Nurasylpro/laser/README.md

# WeedZap: Laser Weeding Robot

A robot that finds weeds with a camera and a custom YOLO model, then drives a laser over each one to burn it. No chemicals, no pulling.

▶️ **Final versions in action:** [YouTube](https://youtu.be/jQHW0xfkkLQ?si=JcptZxX9xMJJeqWb) · [Instagram @w_eedzap](https://www.instagram.com/w_eedzap?stkn=MWl5ODRhbG5hM2NrYg%3D%3D&utm_source=qr)

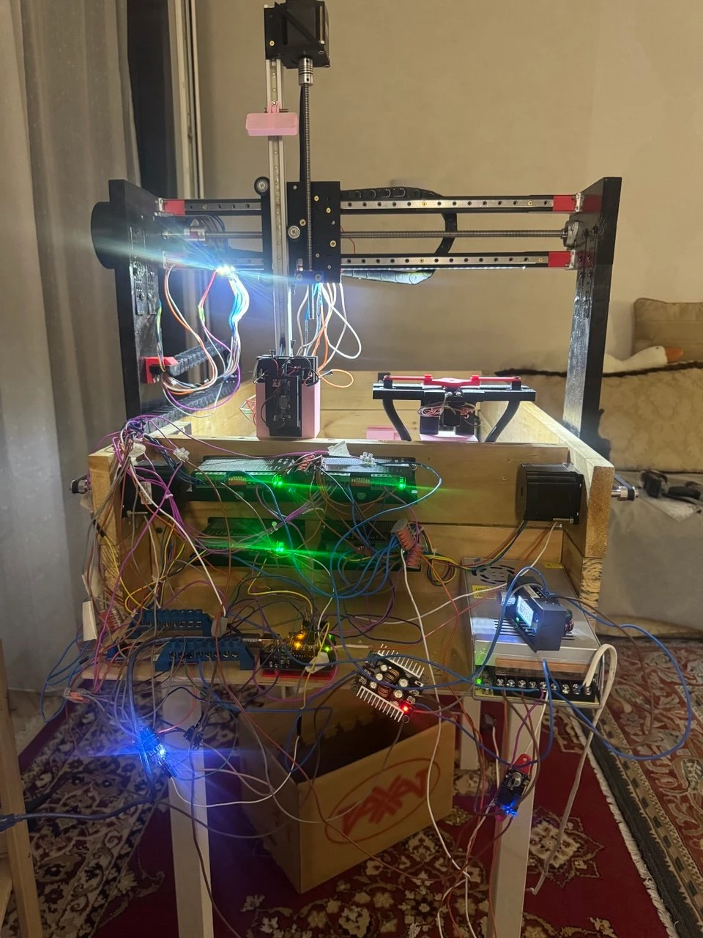
[picture p1: docs/story/gantry-current.webp]
The current WeedZap gantry with its camera, laser tool and drivers


## The story

### 1. It started with a laser in our hands

Before any robot, we had a simple question: can light kill a weed? We took a laser, went out to the garden, and pointed it at a weed by hand.

| Treating the weed by hand | The same weed the next day |
|---|---|
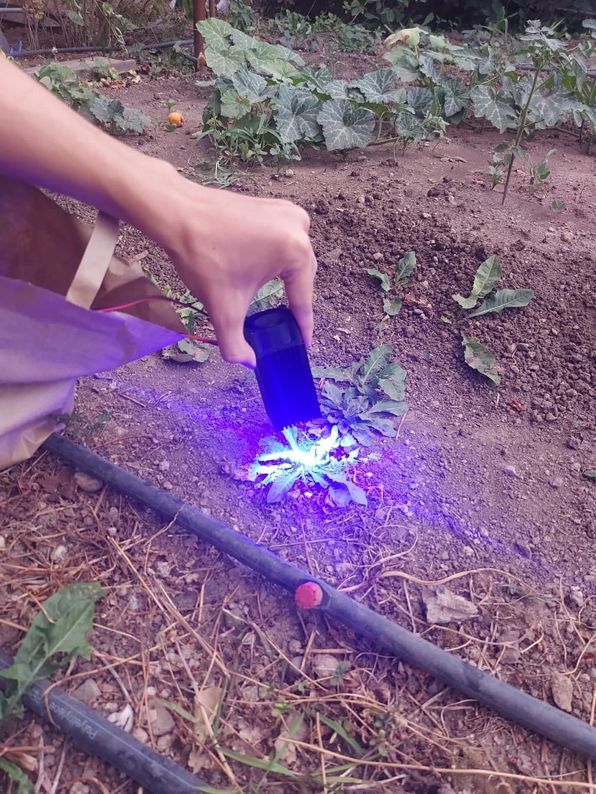
[picture p2: docs/story/hand-laser-test.webp]
Pointing a hand-held laser at a weed in the garden
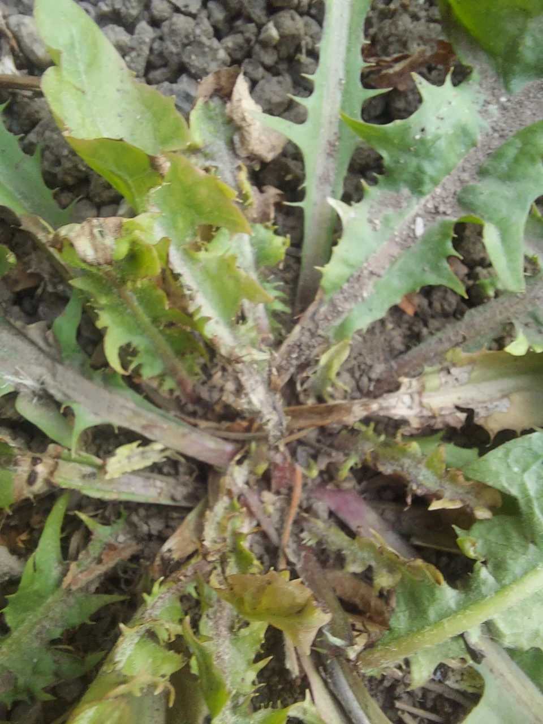
[picture p3: docs/story/weed-next-day.webp]
The treated weed the next day, with damaged stems
|  |  |

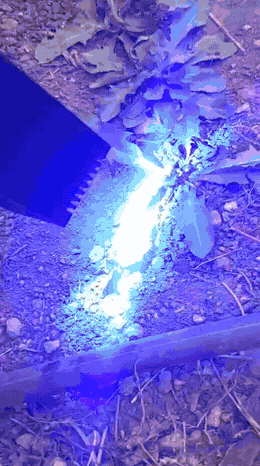
[picture p4: docs/story/first-hand-laser-test.gif]
Video of the first hand-held laser test


🎥 [Watch the full video with sound](docs/story/first-hand-laser-test.mp4)

The next day, the weed showed the answer. The laser had destroyed its **phloem and xylem**, the channels that carry water and nutrients between the root and the leaves. Without them, the plant can't feed its upper part, so it dies. We don't need to burn the whole weed. One precise shot in the right place is enough. That became the core idea of WeedZap.

### 2. Version 1: a small robot for the field

Our first robot was a small wheeled rover built with my team. It drove along the field with a camera. A carriage on a rail moved the laser sideways: the camera detected a weed, and the carriage moved the laser to that position.

| The first field robot | Testing it together |
|---|---|
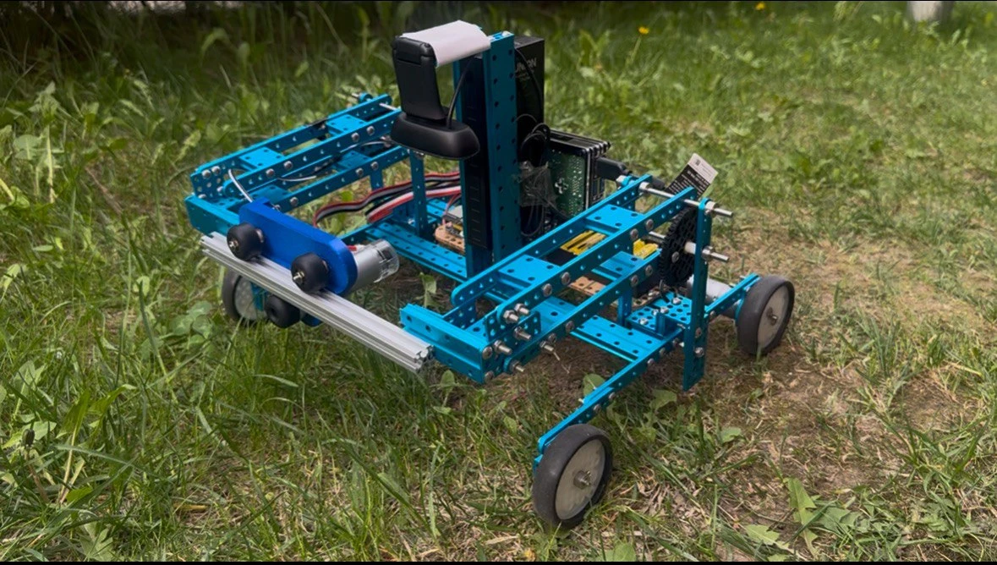
[picture p5: docs/story/v1-field-robot.webp]
The first WeedZap rover with camera and laser carriage on grass
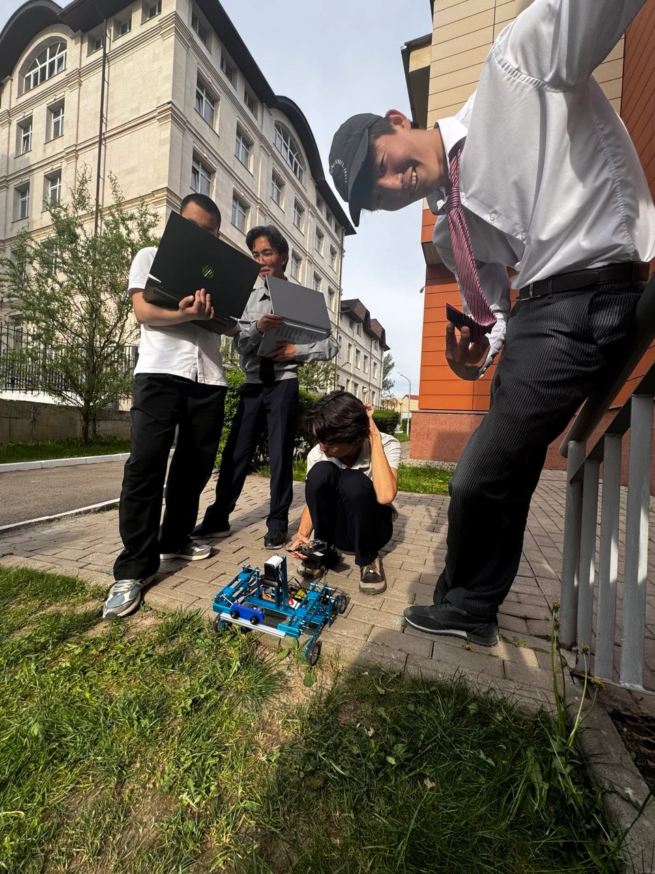
[picture p6: docs/story/v1-team-testing.webp]
The team testing the rover outside
|  |  |

We worked on it for weeks: wiring, coding and testing outside until it worked. Then we presented WeedZap at an exhibition, with a solar-powered frame and a robotic arm version.

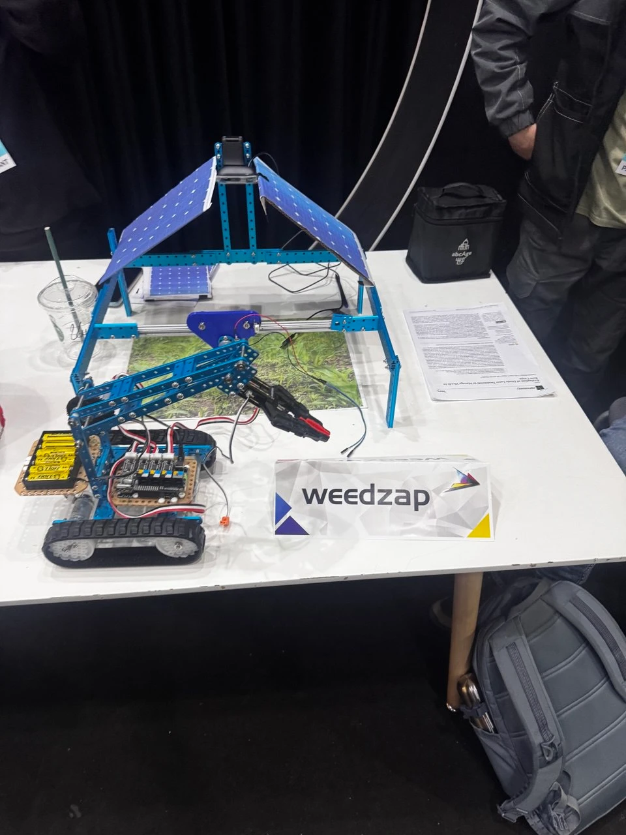
[picture p7: docs/story/v1-expo.webp]
WeedZap presented at the exhibition


### 3. A real high-power laser: NUBM44 V2

The hand test showed the idea works, but a field robot needs real power. We moved to the **NUBM44 V2** high-power blue laser diode. We worked with its driver, connected it to a microcontroller and built a small web page to control its power over Wi-Fi.

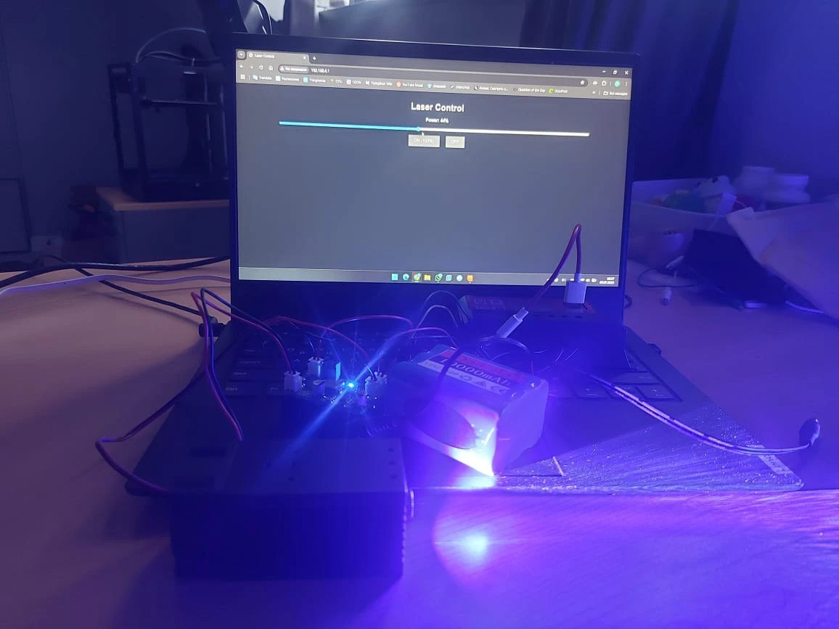
[picture p8: docs/story/nubm44-laser-control.webp]
Controlling the NUBM44 V2 laser power from a web page


### 4. The universal tool mount

For our smart greenhouse, we wanted the laser to work together with a mechanical tool. That meant designing a **universal tool mount**: one carriage that can pick up either the laser or a mechanical tool. This took a lot of design and many prints, more time than almost any other part.

| Design in CAD | Printed parts |
|---|---|
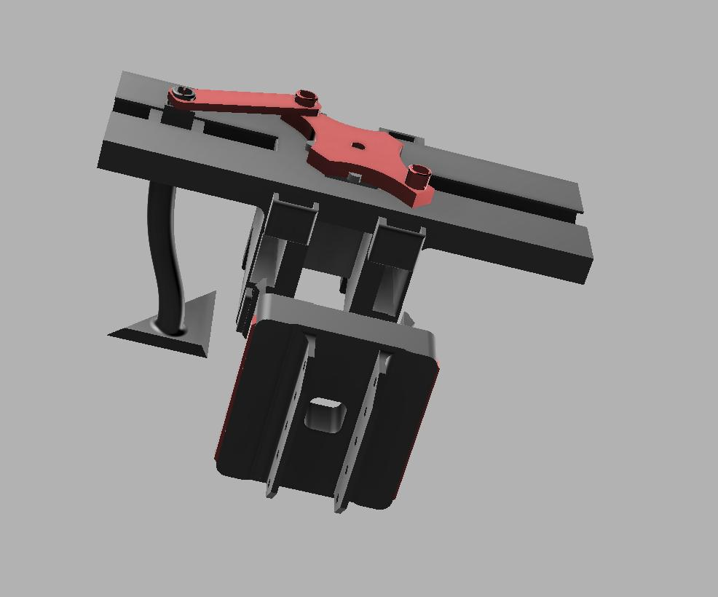
[picture p9: docs/story/tool-mount-cad.png]
CAD model of the universal tool mount
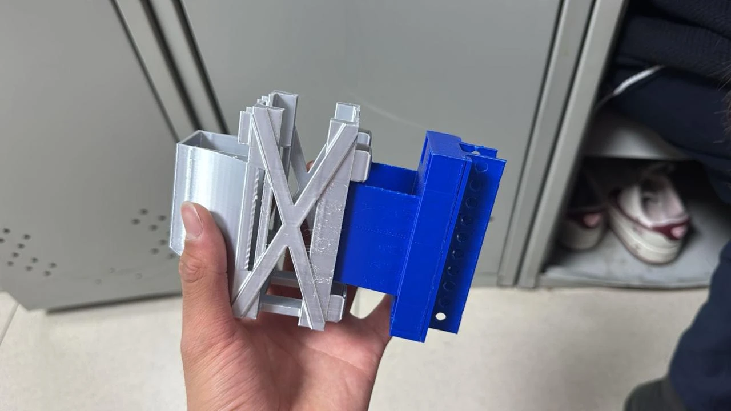
[picture p10: docs/story/tool-mount-printed.webp]
The 3D-printed tool mount parts
|  |  |

### 5. Teaching the robot to see weeds

A laser is useless if it doesn't know where to shoot, so we put a lot of work into computer vision. I collected many weeds myself, planted them in boxes, measured them and photographed them again and again. From those photos I built our own dataset, labelled it and trained **YOLO** models to find each weed and the exact point to hit.

| Growing and measuring weeds for the dataset | |
|---|---|
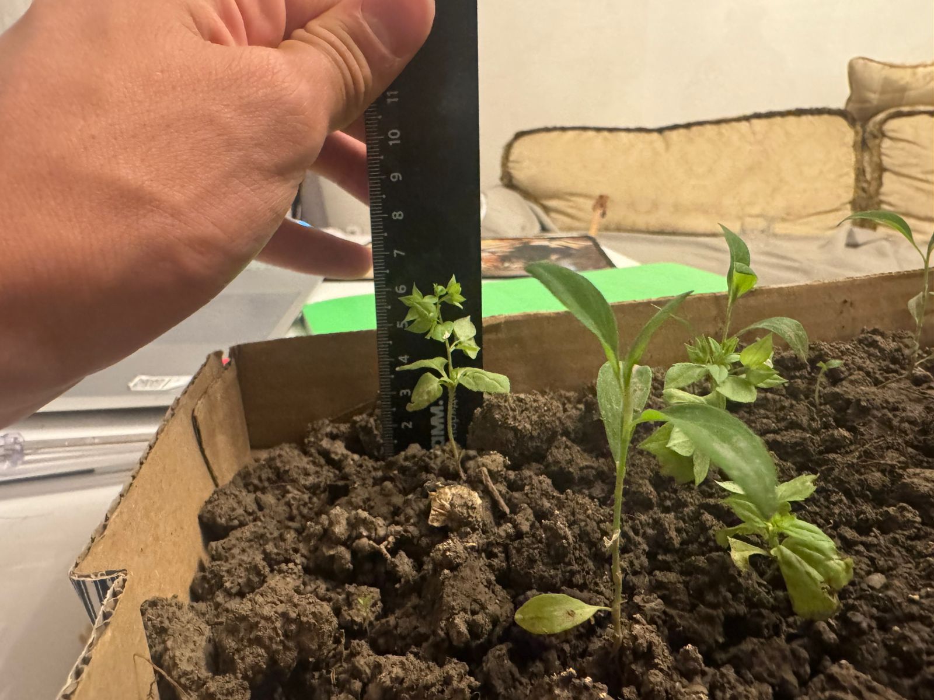
[picture p11: docs/story/weeds-measured-1.jpg]
Weeds planted in a box, measured with a ruler
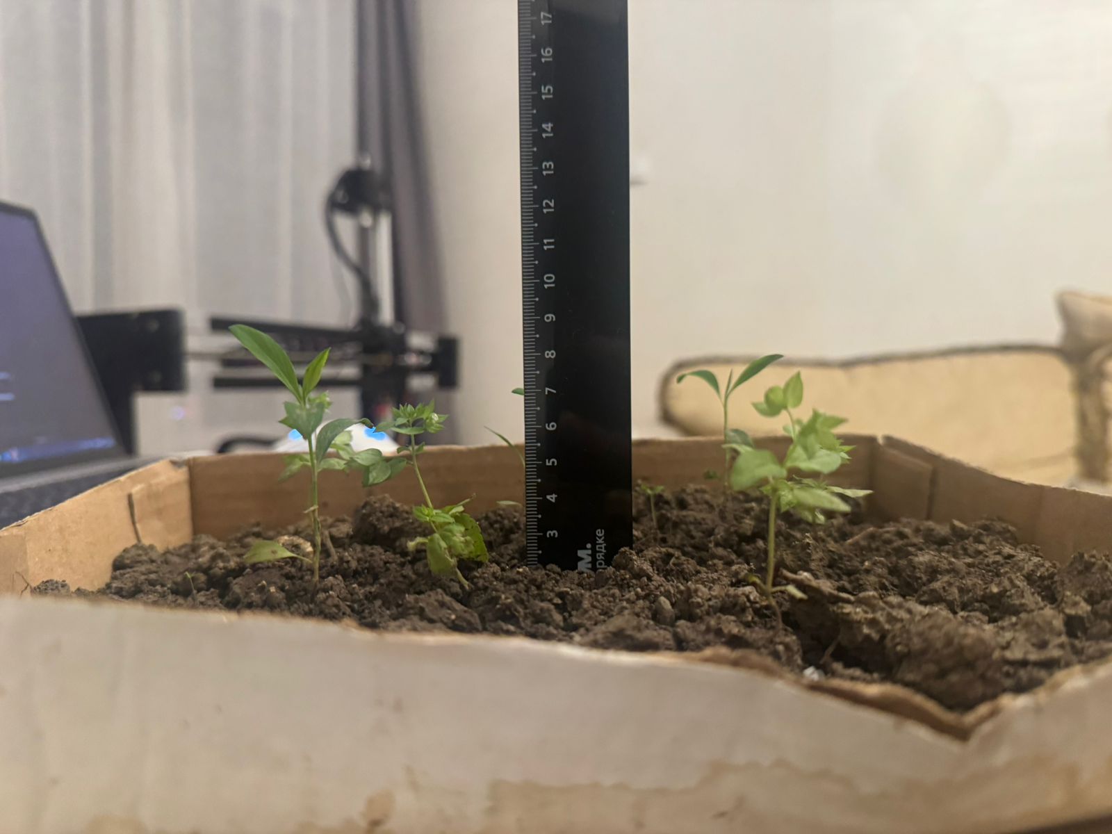
[picture p12: docs/story/weeds-measured-2.jpg]
Another set of weeds measured for the dataset
|  |  |

| What the trained model sees | Detection from the gantry camera |
|---|---|
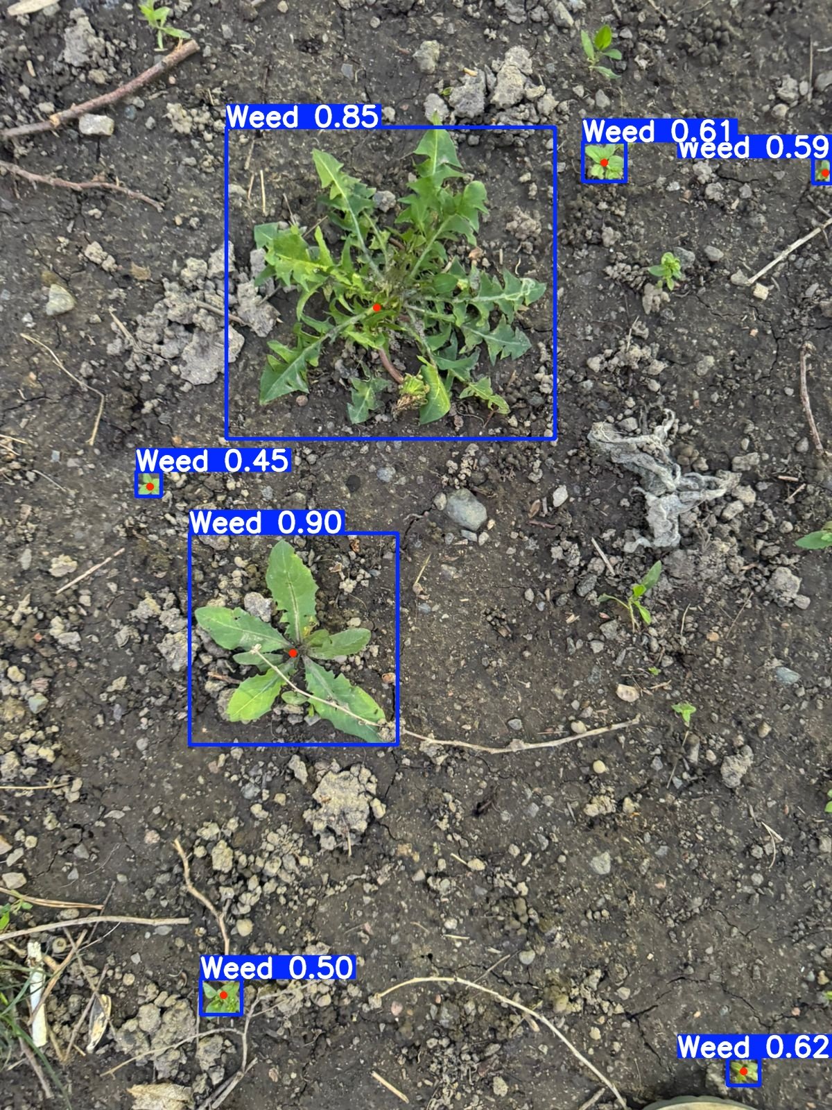
[picture p13: docs/images/weed-pose-model.jpg]
Weed pose model detections with confidence scores
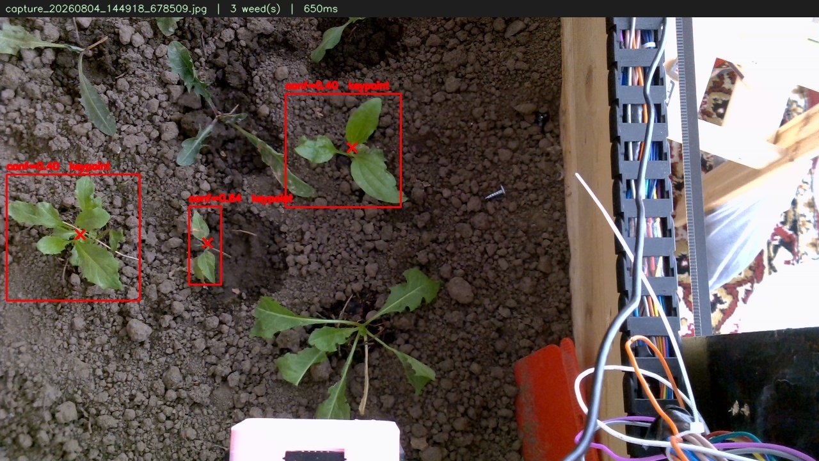
[picture p14: docs/images/gantry-detection.jpg]
Detected weeds from the gantry camera
|  |  |

### 6. Path planning between weeds

Once every weed is found, the robot plans the shortest route between them, so the laser visits each weed once without wasting time.

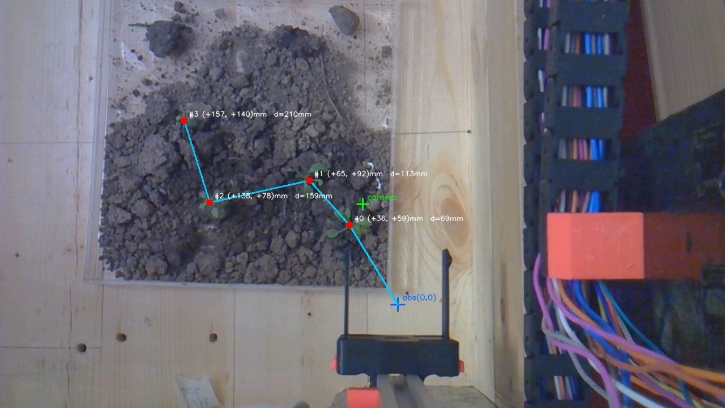
[picture p15: docs/images/path-planning.jpg]
Planned path between detected weeds


### 7. Today: the gantry

Everything came together in the current system: a gantry over the growing bed, a camera, the YOLO model, the NUBM44 laser and the tool mount. The rest of this README describes how it works.

| Zapping a weed in the soil bed | Testing late at night |
|---|---|
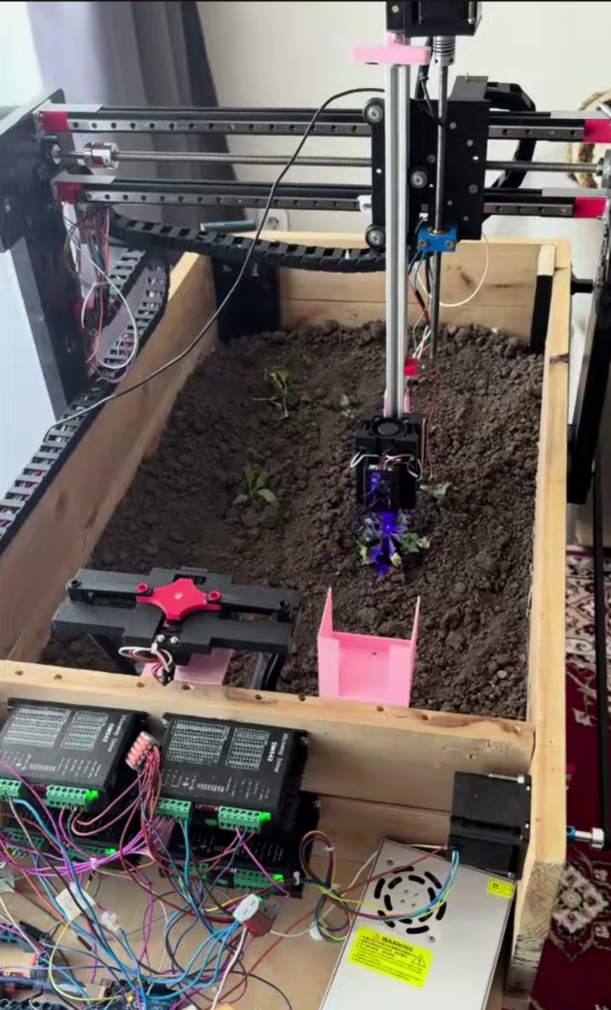
[picture p16: docs/story/gantry-zapping-weed.webp]
The gantry firing the laser at a weed in the soil bed
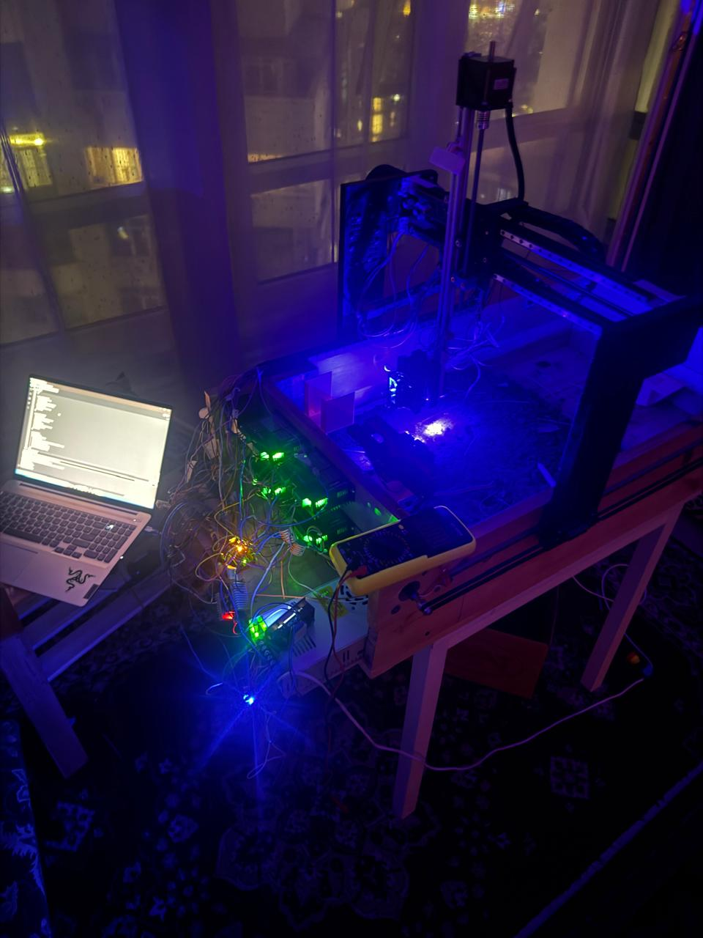
[picture p17: docs/story/gantry-night-test.jpg]
The gantry running a laser test at night
|  |  |

👉 For the final version of each part, watch the videos on [YouTube](https://youtu.be/jQHW0xfkkLQ?si=JcptZxX9xMJJeqWb) and [Instagram](https://www.instagram.com/w_eedzap?stkn=MWl5ODRhbG5hM2NrYg%3D%3D&utm_source=qr).

## Context

| | |
|---|---|
| **Type** | Team hardware project |
| **Built** | 2025 – 2026 |
| **Area** | Computer vision · robotics · embedded |

## How it works

1. **Tour.** The gantry sweeps both rows with no tool attached, so the camera can see. At each stop it photographs the bed and asks the firmware for its real position.
2. **Detect.** A YOLO pose model finds each weed and its crown (the point to burn).
3. **Map.** Pixel coordinates become millimetres using a per-height calibration (homography + polynomial fit), plus a measured camera-to-laser offset.
4. **Zap.** The gantry picks up the laser tool once, then visits every recorded weed and fires.

## Results (current gantry)

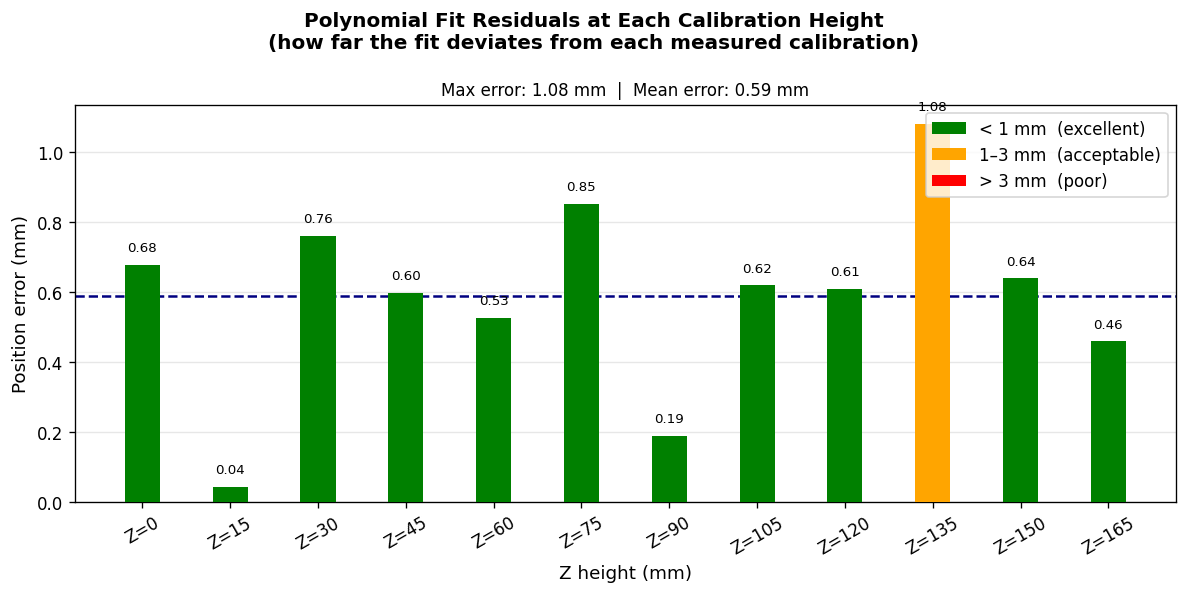
[picture p18: docs/images/calibration-residuals.png]
Polynomial fit residuals at each calibration height


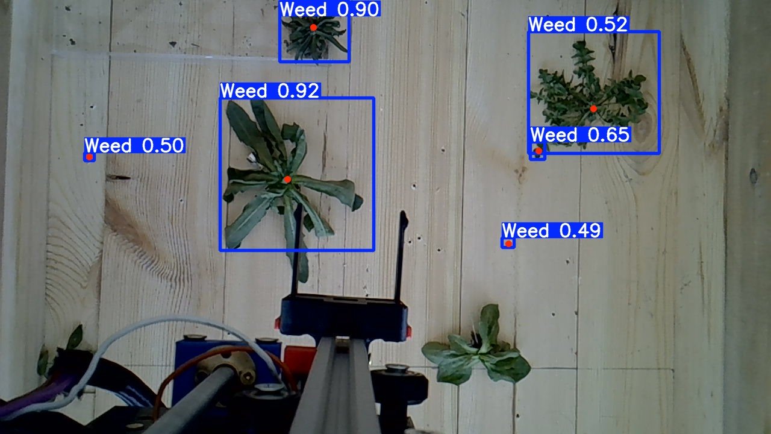
[picture p19: docs/images/bench-test.jpg]
Bench test of the model on printed weeds


## Project structure

| Folder | What's inside |
|---|---|
| `scripts/` | `weed_zap.py` (full run), `path.py` (pixel → mm and routing), `calibrate.py`, `measure_laser_offset.py`, `test_model.py`, debugging tools |
| `model/` | Trained YOLO weights (`best.pt`, …) |
| `calibration/` | Saved calibration per height + camera-to-laser offset |
| `firmware/` | Arduino / ESP32 gantry firmware |

The branch `the-previous-version-without-cv-model` holds the earlier version, from before the CV model was added.

## Tech

Python · Ultralytics YOLO (pose) · OpenCV · NumPy · Arduino / ESP32 · Raspberry Pi

## What I learned

Training and deploying a detection model on real hardware, camera calibration, and debugging where a robot thinks it is versus where it really is.

## Follow WeedZap

- YouTube: https://youtu.be/jQHW0xfkkLQ?si=JcptZxX9xMJJeqWb
- Instagram: [@w_eedzap](https://www.instagram.com/w_eedzap?stkn=MWl5ODRhbG5hM2NrYg%3D%3D&utm_source=qr)
